Electronya/gt-wheel-main-board/README.md

# gt-wheel-main-board
GT DIY Wheel Main Board
