Electronya/gt-wheel-main-board/MainPCB.dxf

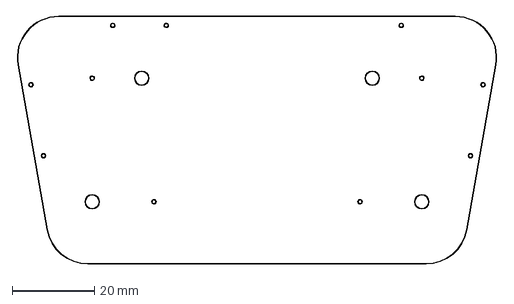
[picture p1: CAD file, 2023-06-29]
MainPCB.dxf
116.9 x 60.0 mm
