Electronya/gt-wheel-main-board/ENYA-SIMR-GTWL-PCMB.kicad_pcb

## KiCad design ENYA-SIMR-GTWL-PCMB.kicad_pcb (2023-11-08)

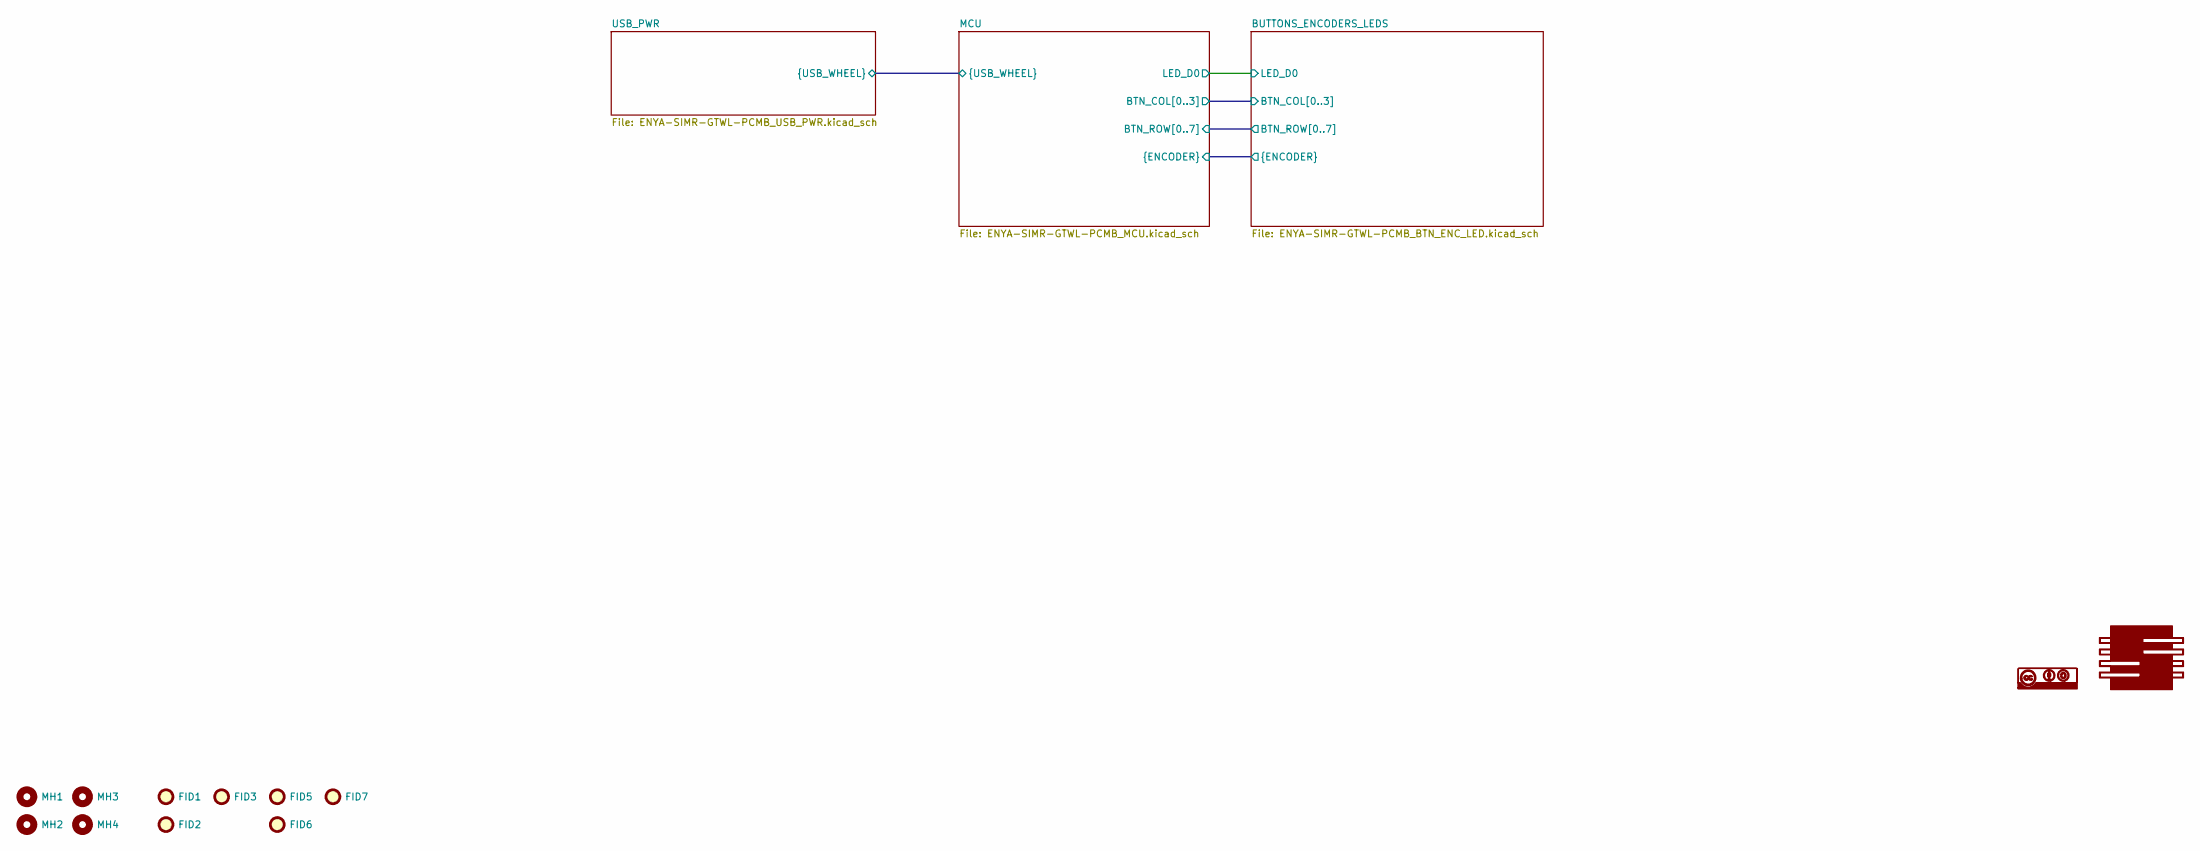
[picture p2: schematic ENYA-SIMR-GTWL-PCMB.kicad_sch, DIY GT Wheel Main Board]

Parts:
FID1, FID2, FID3, FID5, FID6, FID7: Fiducial; Fiducial_1.5mm_Mask3mm
G1: Electronya_Logo; Electronya_Logo_12MM
G2: CC-BY-SA_Logo; CC-BY-SA_10MM
MH1, MH2, MH3, MH4: MH-NPLTD-M3; MountingHole_3.2mm_M3_DIN965

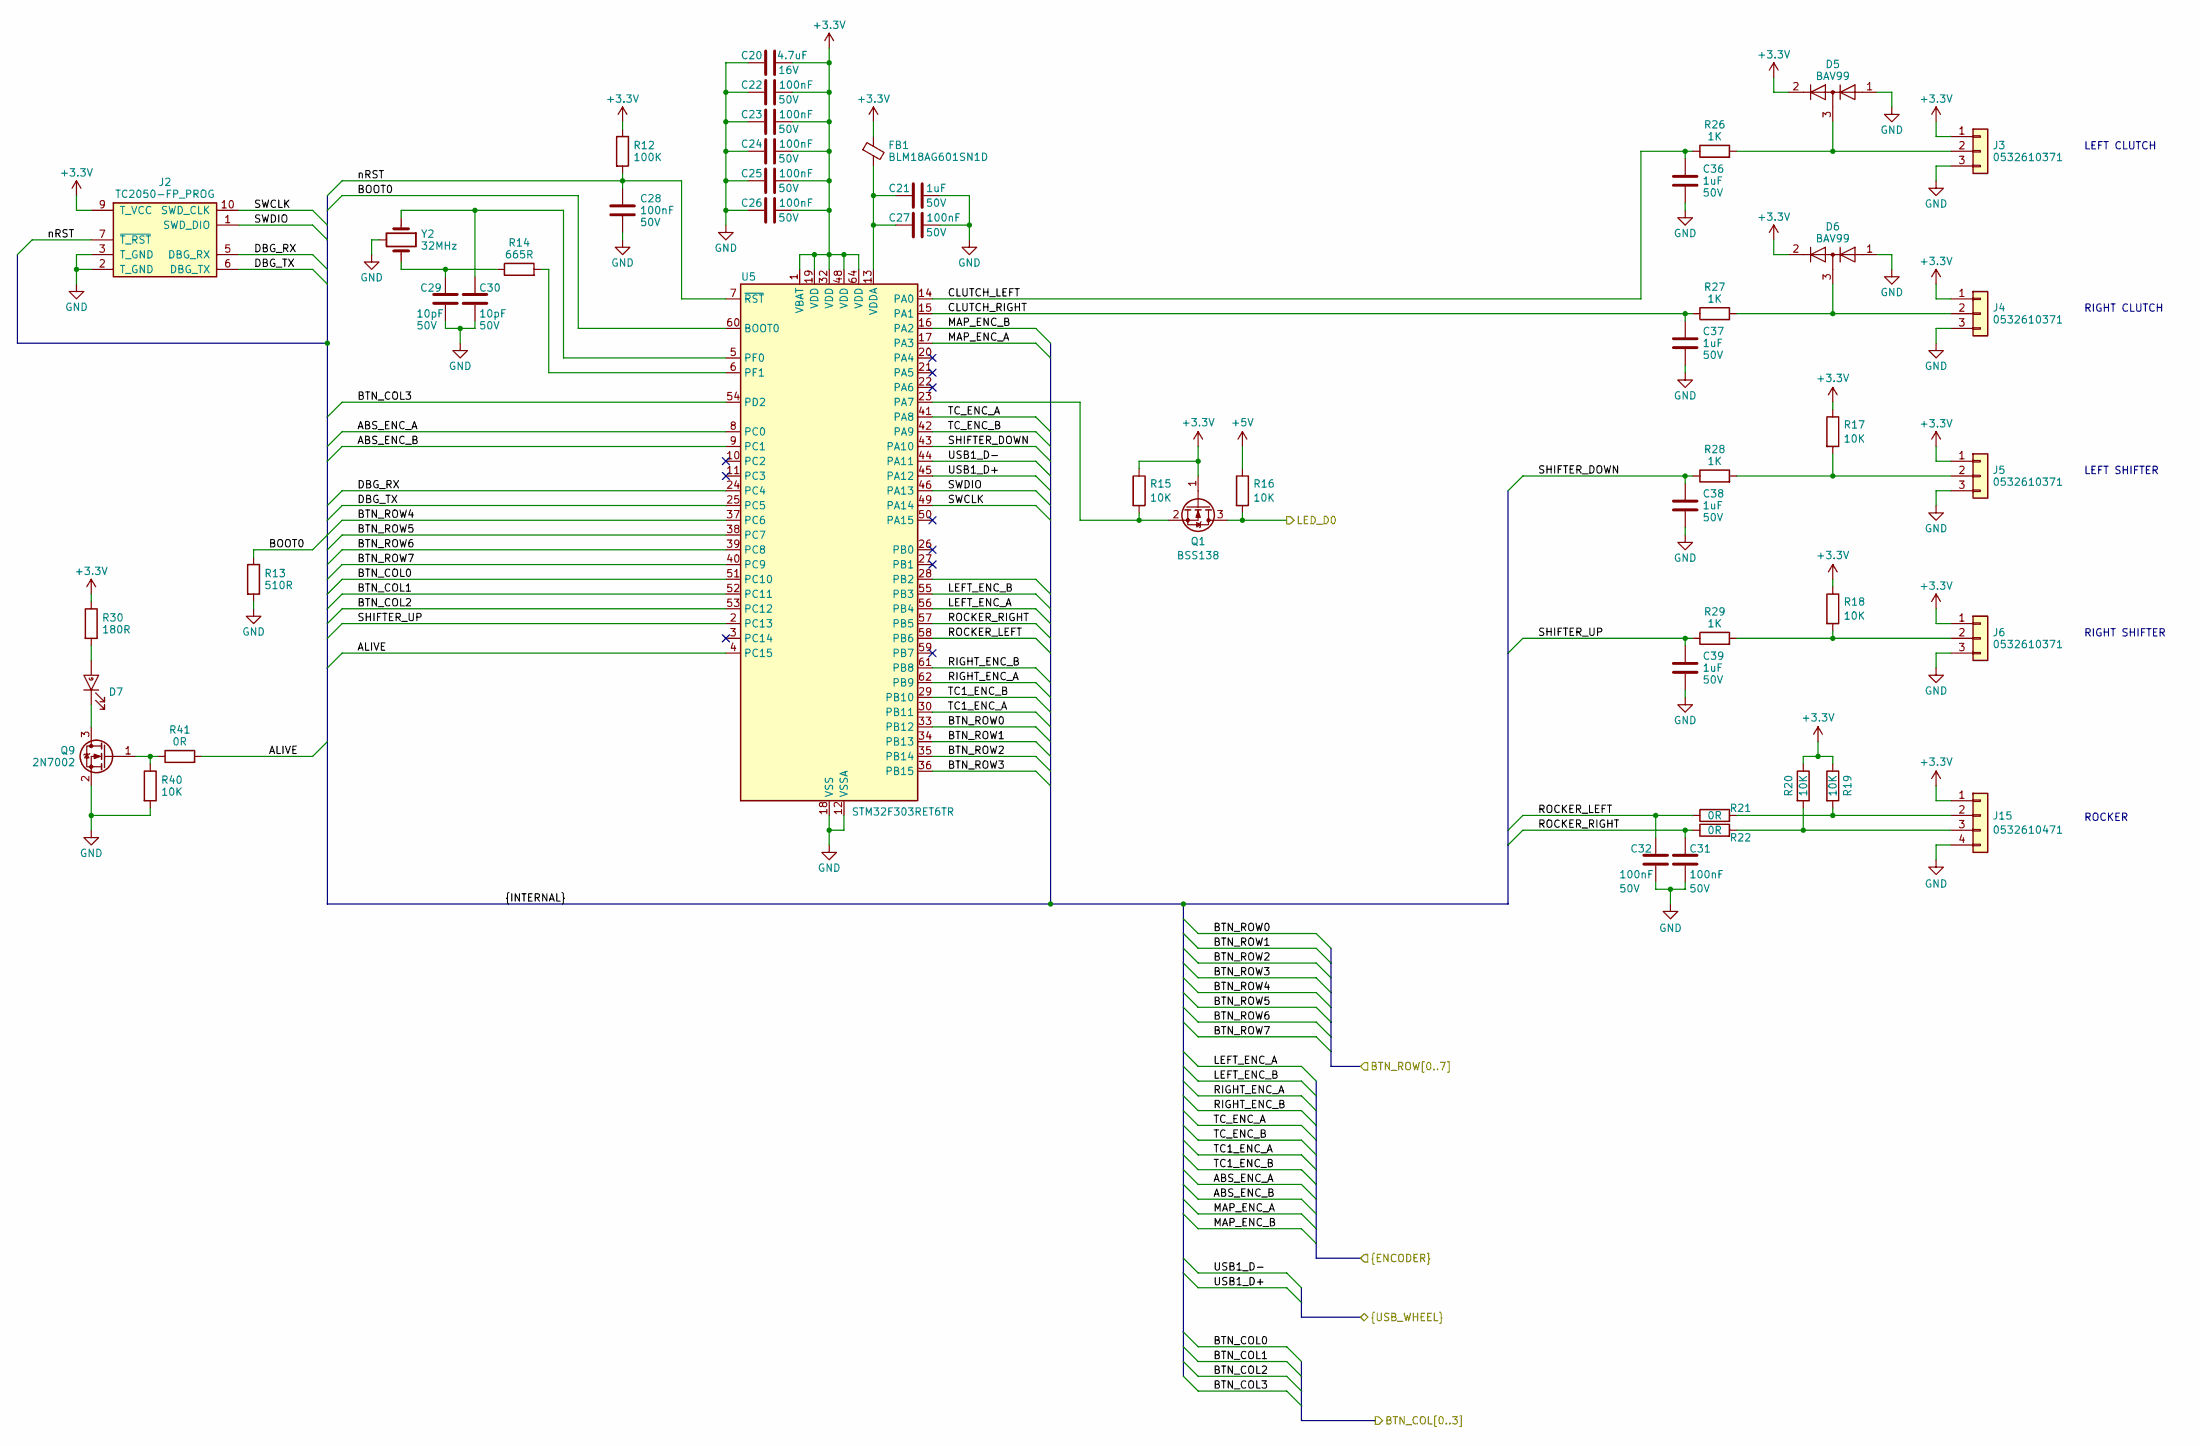
[picture p3: schematic ENYA-SIMR-GTWL-PCMB_MCU.kicad_sch, DIY GT Wheel Main Board]

Parts:
C20: 4.7uF_CER_0805_16V; C_0805_2012Metric; Voltage Rating 16V; Manufacturer Part Number CL21B475KOFNNNE; Digi-Key Part Number 1276-2873-1-ND
C21, C36, C37, C38, C39: 1uF_CER_0603_50V; C_0603_1608Metric; Voltage Rating 50V; Manufacturer Part Number UMK107BJ105KA-T; Digi-Key Part Number 587-2400-1-ND
C22, C23, C24, C25, C26, C27, C28, C31, C32: 100nF_CER_0603_50V; C_0603_1608Metric; Voltage Rating 50V; Manufacturer Part Number 06033D104MAT2A; Digi-Key Part Number 478-7905-1-ND
C29, C30: 10pF_CER_0603_50V; C_0603_1608Metric; Voltage Rating 50V; Manufacturer Part Number 06035A100JAT2A; Digi-Key Part Number 478-1163-1-ND
D5: BAV99; SOT-23
D6: BAV99_SOT-23; SOT-23; Manufacturer Part Number BAV99; Digi-Key Part Number 1655-BAV99CT-ND
D7: GRN_SMD_0603_0.3H; LED_0603_1608Metric; Manufacturer Part Number 150060GS73220; Digi-Key Part Number 732-11995-1-ND
FB1: 600R_100MHz_0R38_0603; L_0603_1608Metric; Manufacturer Part Number BLM18AG601SN1D; Digi-Key Part Number 490-1014-1-ND
J2: TC2050-FP_PROG; Tag-Connect_TC2050-IDC-FP_2x05_P1.27mm_Vertical; Manufacturer Part Number TC2050-FP
J3, J4, J5, J6: PICO_BLADE_1x3_MALE_RA_SMD; PICO_BLADE_53261_1x3_SMD_RA_1.25MM; Manufacturer Part Number 0532610371; Digi-Key Part Number WM7621CT-ND
J15: PICO_BLADE_1x4_MALE_RA_SMD; PICO_BLADE_53261_1x4_SMD_RA_1.25MM; Manufacturer Part Number 0532610471; Digi-Key Part Number WM7622CT-ND
Q1: BSS138; SOT-23; Manufacturer Part Number BSS138; Digi-Key Part Number BSS138CT-ND
Q9: 2N7002; SOT-23; Manufacturer Part Number 2N7002; Digi-Key Part Number 2N7002NCT-ND
R12: 100K_0603_100MW; R_0603_1608Metric; Manufacturer Part Number RC0603FR-07100KL; Digi-Key Part Number 311-100KHRCT-ND
R13: 510R_0603_100MW; R_0603_1608Metric; Manufacturer Part Number RC0603FR-07510RL; Digi-Key Part Number 311-510HRCT-ND
R14: 665R_0603_100MW; R_0603_1608Metric; Manufacturer Part Number RC0603FR-07665RL; Digi-Key Part Number 311-665HRCT-ND
R15, R16, R17, R18, R19, R20, R40: 10K_0603_100MW; R_0603_1608Metric; Manufacturer Part Number ERJ-3EKF1002V; Digi-Key Part Number P10.0KHCT-ND
R21, R22, R41: 0R_0603_100MW; R_0603_1608Metric; Manufacturer Part Number ERJ-3GEY0R00V; Digi-Key Part Number P0.0GCT-ND
R26, R27, R28, R29: 1K_0603_100MW; R_0603_1608Metric; Manufacturer Part Number ERJ-3EKF1001V; Digi-Key Part Number P1.00KHCT-ND
R30: 180R_0603_100MW; R_0603_1608Metric; Manufacturer Part Number RC0603FR-07180RL; Digi-Key Part Number 311-180HRCT-ND
U5: STM32F303RET6TR; LQFP-64_10x10mm_P0.5mm; Manufacturer Part Number STM32F303RET6TR; Digi-Key Part Number 497-18778-1-ND
Y2: ABM10_32MHz_10pF_SMD4_2.5x2.0; ABM10_SMD4_2.5x2.0mm; Manufacturer Part Number ABM10-32.000MHZ-D30-T3; Digi-Key Part Number 535-10936-1-ND

Connections:
+3.3V: C20.2, C22.2, C23.2, C24.2, C25.2, C26.2, D5.2 (A), D6.2 (A), FB1.1, J2.9 (T_VCC), J3.1, J4.1, J5.1, J6.1, J15.1, Q1.1 (G), R12.1, R15.1, R17.1, R18.1, R19.1, R20.1, R30.1, U5.1 (VBAT), U5.19 (VDD), U5.32 (VDD), U5.48 (VDD), U5.64 (VDD); also elsewhere on the board
+5V: R16.1; also elsewhere on the board
/BUTTONS_ENCODERS_LEDS/ABS_ENC_A: U5.8 (PC0); also elsewhere on the board
/BUTTONS_ENCODERS_LEDS/ABS_ENC_B: U5.9 (PC1); also elsewhere on the board
/BUTTONS_ENCODERS_LEDS/BTN_COL0: U5.51 (PC10); also elsewhere on the board
/BUTTONS_ENCODERS_LEDS/BTN_COL1: U5.52 (PC11); also elsewhere on the board
/BUTTONS_ENCODERS_LEDS/BTN_COL2: U5.53 (PC12); also elsewhere on the board
/BUTTONS_ENCODERS_LEDS/BTN_COL3: U5.54 (PD2); also elsewhere on the board
/BUTTONS_ENCODERS_LEDS/BTN_ROW0: U5.33 (PB12); also elsewhere on the board
/BUTTONS_ENCODERS_LEDS/BTN_ROW1: U5.34 (PB13); also elsewhere on the board
/BUTTONS_ENCODERS_LEDS/BTN_ROW2: U5.35 (PB14); also elsewhere on the board
/BUTTONS_ENCODERS_LEDS/BTN_ROW3: U5.36 (PB15); also elsewhere on the board
/BUTTONS_ENCODERS_LEDS/BTN_ROW4: U5.37 (PC6); also elsewhere on the board
/BUTTONS_ENCODERS_LEDS/BTN_ROW5: U5.38 (PC7); also elsewhere on the board
/BUTTONS_ENCODERS_LEDS/BTN_ROW6: U5.39 (PC8); also elsewhere on the board
/BUTTONS_ENCODERS_LEDS/BTN_ROW7: U5.40 (PC9); also elsewhere on the board
/BUTTONS_ENCODERS_LEDS/LED_D0: Q1.3 (D), R16.2; also elsewhere on the board
/BUTTONS_ENCODERS_LEDS/LEFT_ENC_A: U5.56 (PB4); also elsewhere on the board
/BUTTONS_ENCODERS_LEDS/LEFT_ENC_B: U5.55 (PB3); also elsewhere on the board
/BUTTONS_ENCODERS_LEDS/MAP_ENC_A: U5.17 (PA3); also elsewhere on the board
/BUTTONS_ENCODERS_LEDS/MAP_ENC_B: U5.16 (PA2); also elsewhere on the board
/BUTTONS_ENCODERS_LEDS/RIGHT_ENC_A: U5.62 (PB9); also elsewhere on the board
/BUTTONS_ENCODERS_LEDS/RIGHT_ENC_B: U5.61 (PB8); also elsewhere on the board
/BUTTONS_ENCODERS_LEDS/TC1_ENC_A: U5.30 (PB11); also elsewhere on the board
/BUTTONS_ENCODERS_LEDS/TC1_ENC_B: U5.29 (PB10); also elsewhere on the board
/BUTTONS_ENCODERS_LEDS/TC_ENC_A: U5.41 (PA8); also elsewhere on the board
/BUTTONS_ENCODERS_LEDS/TC_ENC_B: U5.42 (PA9); also elsewhere on the board
/MCU/ALIVE: R41.2, U5.4 (PC15)
/MCU/BOOT0: R13.1, U5.60 (BOOT0)
/MCU/CLUTCH_LEFT: C36.1, R26.1, U5.14 (PA0)
/MCU/CLUTCH_RIGHT: C37.1, R27.1, U5.15 (PA1)
/MCU/DBG_RX: J2.5 (DBG_RX), U5.24 (PC4)
/MCU/DBG_TX: J2.6 (DBG_TX), U5.25 (PC5)
/MCU/ROCKER_LEFT: C32.1, R21.1, U5.58 (PB6)
/MCU/ROCKER_RIGHT: C31.1, R22.1, U5.57 (PB5)
/MCU/SHIFTER_DOWN: C38.1, R28.1, U5.43 (PA10)
/MCU/SHIFTER_UP: C39.1, R29.1, U5.2 (PC13)
/MCU/SWCLK: J2.10 (SWD_CLK), U5.49 (PA14)
/MCU/SWDIO: J2.1 (SWD_DIO), U5.46 (PA13)
/MCU/USB1_D+: U5.45 (PA12); also elsewhere on the board
/MCU/USB1_D-: U5.44 (PA11); also elsewhere on the board
/MCU/nRST: C28.1, J2.7 (~T_RST), R12.2, U5.7 (~RST)
GND: C20.1, C21.2, C22.1, C23.1, C24.1, C25.1, C26.1, C27.2, C28.2, C29.2, C30.2, C31.2, C32.2, C36.2, C37.2, C38.2, C39.2, D5.1 (K), D6.1 (K), J2.2 (T_GND), J2.3 (T_GND), J3.3, J4.3, J5.3, J6.3, J15.4, Q9.2 (S), R13.2, R40.2, U5.12 (VSSA), U5.18 (VSS), U5.31 (VSS), U5.47 (VSS), U5.63 (VSS), Y2.2 (GND), Y2.4 (GND); also elsewhere on the board
unnamed: C29.1, R14.1, Y2.3
unnamed: D7.2 (A), R30.2
unnamed: D7.1 (K), Q9.3 (D)
unnamed: D5.3 (K), J3.2, R26.2
unnamed: D6.3 (K), J4.2, R27.2
unnamed: J5.2, R17.2, R28.2
unnamed: J6.2, R18.2, R29.2
unnamed: J15.2, R19.2, R21.2
unnamed: J15.3, R20.2, R22.2
unnamed: Q1.2 (S), R15.2, U5.23 (PA7)
unnamed: Q9.1 (G), R40.1, R41.1
unnamed: C30.1, U5.5 (PF0), Y2.1
unnamed: R14.2, U5.6 (PF1)
unnamed: C21.1, C27.1, FB1.2, U5.13 (VDDA)

Notes on the sheet:
RIGHT CLUTCH
RIGHT SHIFTER
ROCKER
LEFT SHIFTER
LEFT CLUTCH

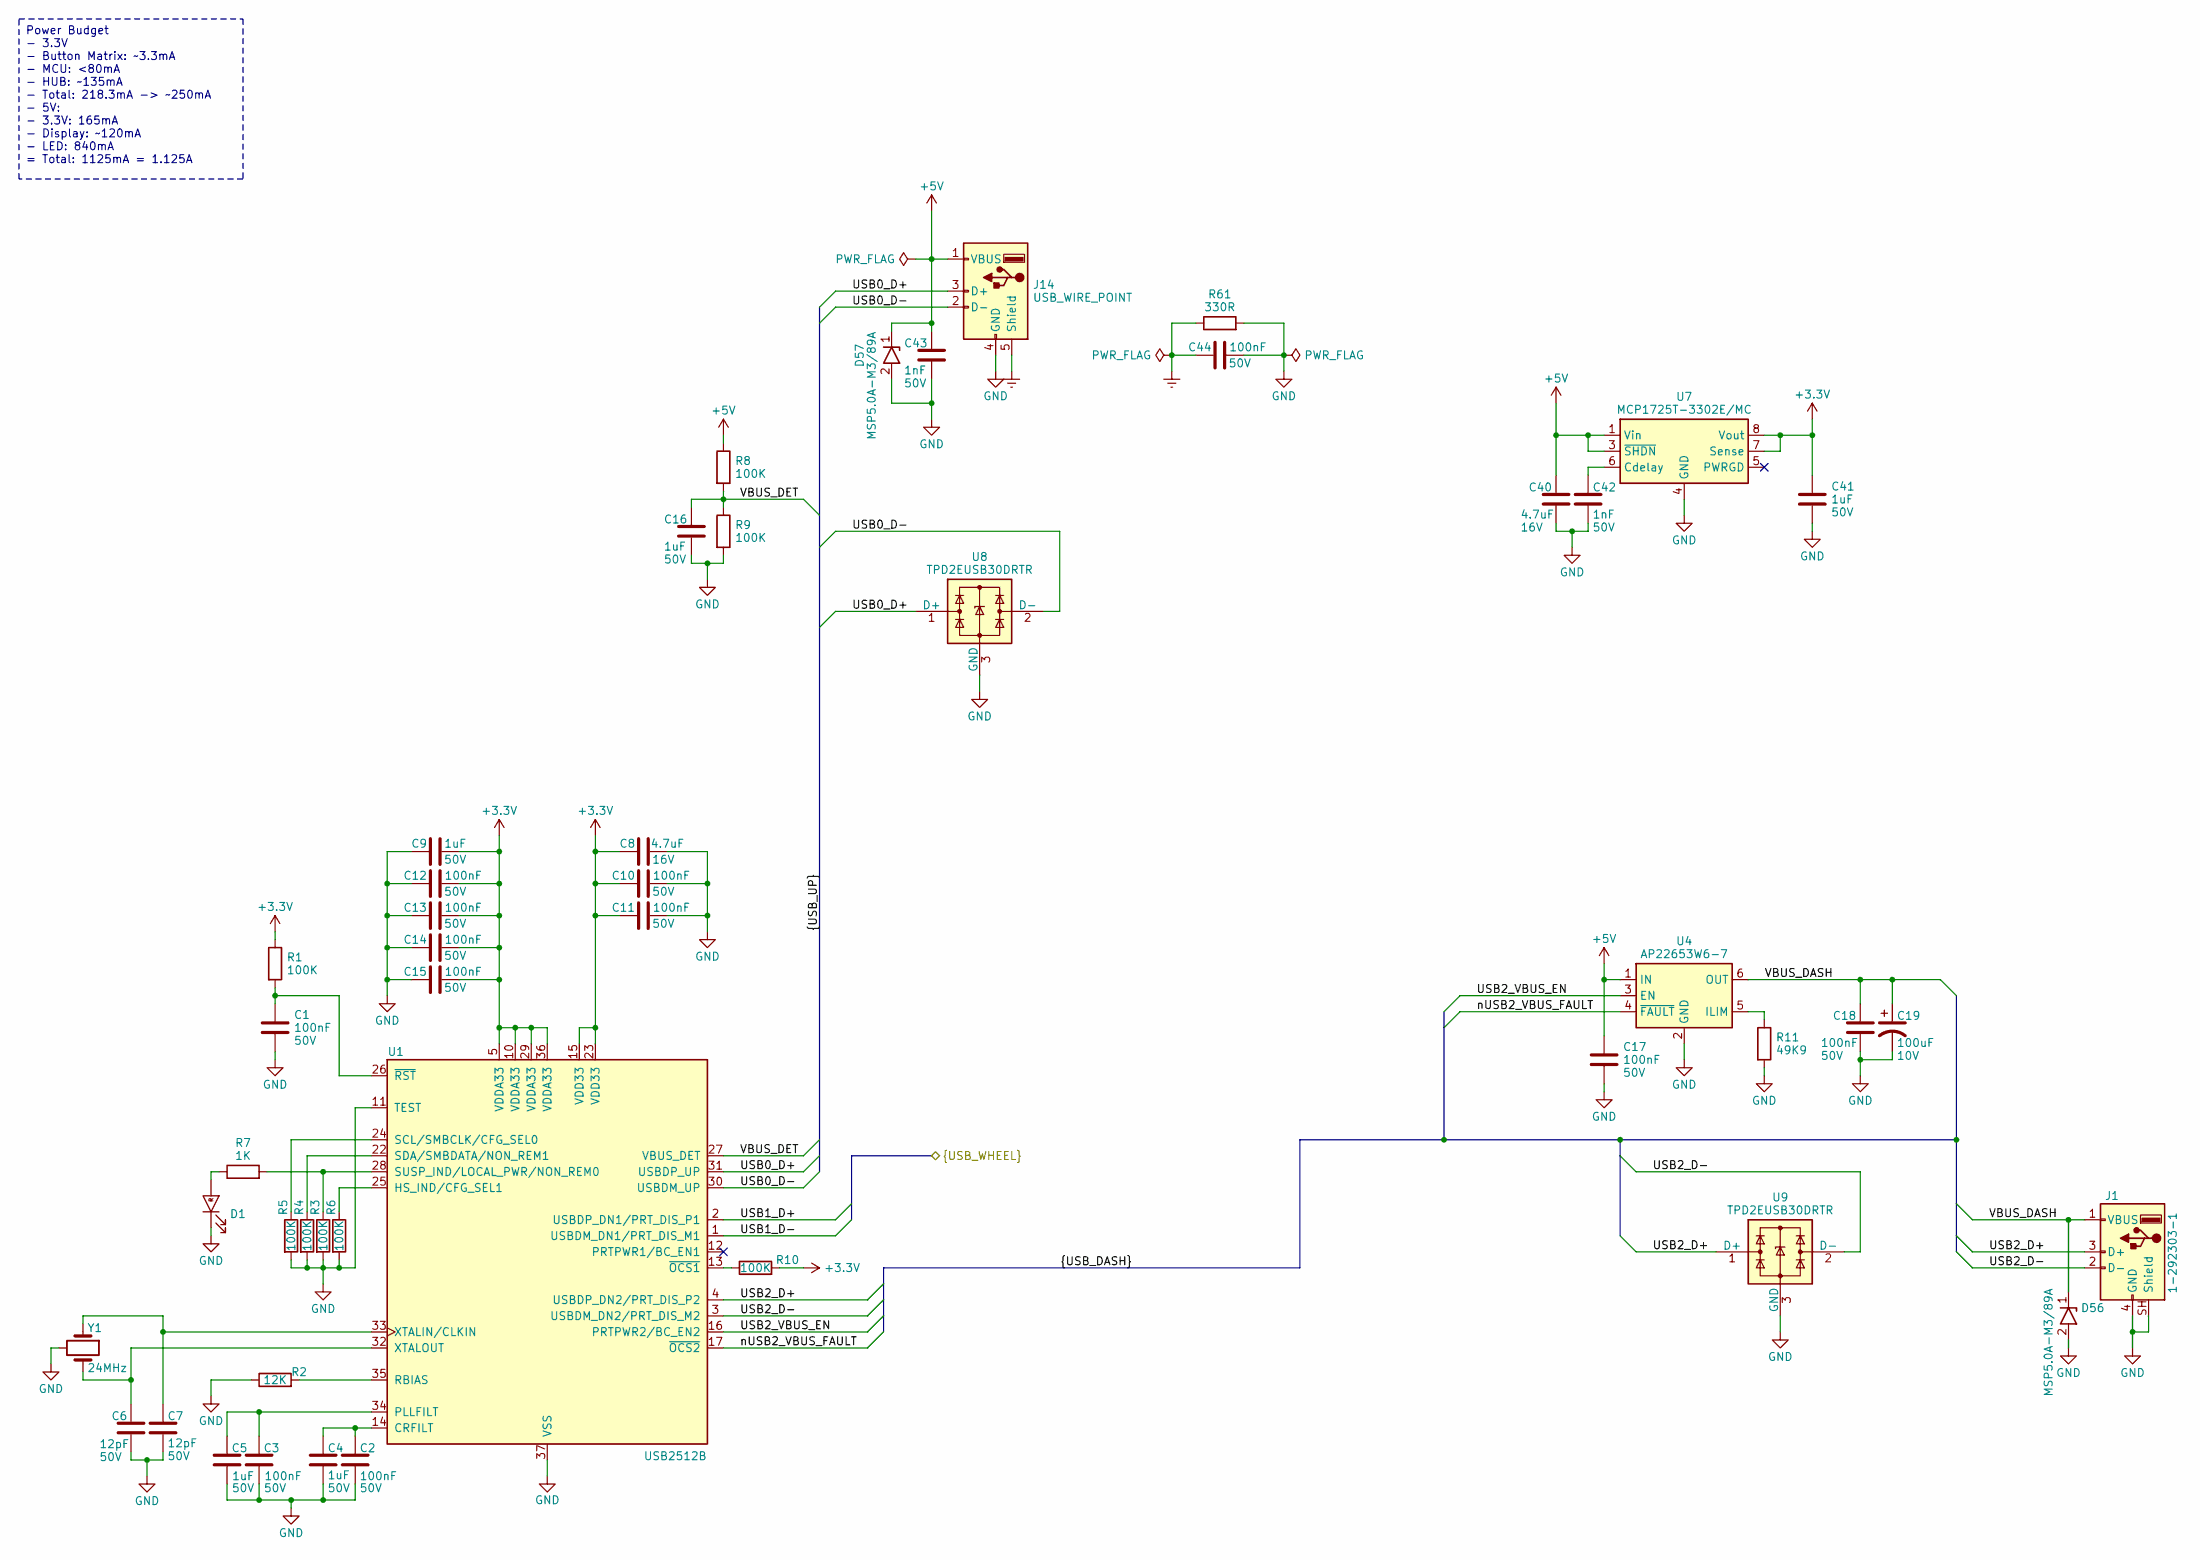
[picture p4: schematic ENYA-SIMR-GTWL-PCMB_USB_PWR.kicad_sch, DIY GT Wheel Main Board]

Parts:
C1, C2, C3, C10, C11, C12, C13, C14, C15, C17, C18, C44: 100nF_CER_0603_50V; C_0603_1608Metric; Voltage Rating 50V; Manufacturer Part Number 06033D104MAT2A; Digi-Key Part Number 478-7905-1-ND
C4, C5, C9, C16, C41: 1uF_CER_0603_50V; C_0603_1608Metric; Voltage Rating 50V; Manufacturer Part Number UMK107BJ105KA-T; Digi-Key Part Number 587-2400-1-ND
C6, C7: 12pF_CER_0603_50V; C_0603_1608Metric; Voltage Rating 50V; Manufacturer Part Number CGA3E2C0G1H120J080AA; Digi-Key Part Number 445-5629-1-ND
C8, C40: 4.7uF_CER_0805_16V; C_0805_2012Metric; Voltage Rating 16V; Manufacturer Part Number CL21B475KOFNNNE; Digi-Key Part Number 1276-2873-1-ND
C19: 100UF_TANT_2917_10V; CP_EIA-7343-15_Kemet-W; Voltage Rating 10V; Manufacturer Part Number TAJD107M010RNJ; Digi-Key Part Number 478-3918-1-ND
C42, C43: 1nF_CER_0603_50V; C_0603_1608Metric; Voltage Rating 50V; Manufacturer Part Number C0603C102K5RAC7867; Digi-Key Part Number 399-C0603C102K5RAC7867CT-ND
D1: RED_SMD_0603_0.3H; LED_0603_1608Metric; Manufacturer Part Number 150060RS75000; Digi-Key Part Number 732-4978-1-ND
D56, D57: MSP5.0A_5V_9.2V_D0-219AD; DO-219AD; Manufacturer Part Number MSP5.0A-M3/89A; Digi-Key Part Number MSP5.0A-M3/89AGICT-ND
J1: USB_A_RA; Manufacturer Part Number 1-292303-1; Digi-Key Part Number A127890-ND
J14: USB_WIRE_POINT
R1, R3, R4, R5, R6, R8, R9, R10: 100K_0603_100MW; R_0603_1608Metric; Manufacturer Part Number RC0603FR-07100KL; Digi-Key Part Number 311-100KHRCT-ND
R2: 12K_0603_100MW; R_0603_1608Metric; Manufacturer Part Number RC0603FR-0712KL; Digi-Key Part Number 311-12.0KHRCT-ND
R7: 1K_0603_100MW; R_0603_1608Metric; Manufacturer Part Number ERJ-3EKF1001V; Digi-Key Part Number P1.00KHCT-ND
R11: 49K9_0603_100MW; R_0603_1608Metric; Manufacturer Part Number CRCW060349K9FKEAC; Digi-Key Part Number 541-3989-1-ND
R61: 330R_0603_100MW; R_0603_1608Metric; Manufacturer Part Number RC0603FR-07330RL; Digi-Key Part Number 311-330HRCT-ND
U1: USB2512B; QFN-36-1EP_6x6mm_P0.5mm_EP3.7x3.7mm; Manufacturer Part Number USB2512B-AEZG-TR; Digi-Key Part Number USB2512B-AEZG-CT-ND
U4: AP22653W6-7_ILIM_2.1A_SOT-23-6; SOT-23-6; Manufacturer Part Number AP22653W6-7; Digi-Key Part Number 31-AP22653W6-7CT-ND
U7: MCP1725_3.3V_500mA_DFN-8; DFN-8-1EP_3x2mm_P0.5mm_EP1.75x1.45mm; Manufacturer Part Number MCP1725T-3302E/MC; Digi-Key Part Number MCP1725T-3302E/MCCT-ND
U8, U9: TPD2EUSB30_5.5V_8V_SOT-3; Texas_DRT-3; Manufacturer PArt Number TPD2EUSB30DRTR; Digi-Key Part Number 296-25509-1-ND
Y1: ABM10_24MHz_10pF_SMD4_2.5x2.0; ABM10_SMD4_2.5x2.0mm; Manufacturer Part Number ABM10-24.000MHZ-E20-T; Digi-Key Part Number 535-9093-1-ND

Connections:
+3.3V: C8.1, C9.2, C10.1, C11.1, C12.2, C13.2, C14.2, C15.2, C41.1, R1.1, R10.2, U1.5 (VDDA33), U1.10 (VDDA33), U1.15 (VDD33), U1.23 (VDD33), U1.29 (VDDA33), U1.36 (VDDA33), U7.7 (Sense), U7.8 (Vout); also elsewhere on the board
+5V: C17.1, C40.1, C43.1, D57.1 (A1), J14.1 (VBUS), R8.1, U4.1 (IN), U7.1 (Vin), U7.2 (Vin), U7.3 (~SHDN); also elsewhere on the board
/MCU/USB1_D+: U1.2 (USBDP_DN1/PRT_DIS_P1); also elsewhere on the board
/MCU/USB1_D-: U1.1 (USBDM_DN1/PRT_DIS_M1); also elsewhere on the board
/USB_PWR/USB0_D+: J14.3 (D+), U1.31 (USBDP_UP), U8.1 (D+)
/USB_PWR/USB0_D-: J14.2 (D-), U1.30 (USBDM_UP), U8.2 (D-)
/USB_PWR/USB2_D+: J1.3 (D+), U1.4 (USBDP_DN2/PRT_DIS_P2), U9.1 (D+)
/USB_PWR/USB2_D-: J1.2 (D-), U1.3 (USBDM_DN2/PRT_DIS_M2), U9.2 (D-)
/USB_PWR/USB2_VBUS_EN: U1.16 (PRTPWR2/BC_EN2), U4.3 (EN)
/USB_PWR/VBUS_DASH: C18.1, C19.1, D56.1 (A1), J1.1 (VBUS), U4.6 (OUT)
/USB_PWR/VBUS_DET: C16.1, R8.2, R9.1, U1.27 (VBUS_DET)
/USB_PWR/nUSB2_VBUS_FAULT: U1.17 (~OCS2), U4.4 (~FAULT)
Earth: C44.1, J14.5 (Shield), R61.1
GND: C1.2, C2.2, C3.2, C4.2, C5.2, C6.2, C7.2, C8.2, C9.1, C10.2, C11.2, C12.1, C13.1, C14.1, C15.1, C16.2, C17.2, C18.2, C19.2, C40.2, C41.2, C42.2, C43.2, C44.2, D1.1 (K), D56.2 (A2), D57.2 (A2), J1.4 (GND), J1.SH (Shield), J14.4 (GND), R2.1, R3.2, R4.2, R5.2, R6.2, R9.2, R11.2, R61.2, U1.11 (TEST), U1.37 (VSS), U4.2 (GND), U7.4 (GND), U7.9 (GND), U8.3 (GND), U9.3 (GND), Y1.2 (GND), Y1.4 (GND); also elsewhere on the board
unnamed: D1.2 (A), R7.1
unnamed: C2.1, C4.1, U1.14 (CRFILT)
unnamed: R6.1, U1.25 (HS_IND/CFG_SEL1)
unnamed: C3.1, C5.1, U1.34 (PLLFILT)
unnamed: R2.2, U1.35 (RBIAS)
unnamed: R5.1, U1.24 (SCL/SMBCLK/CFG_SEL0)
unnamed: R4.1, U1.22 (SDA/SMBDATA/NON_REM1)
unnamed: R3.1, R7.2, U1.28 (SUSP_IND/LOCAL_PWR/NON_REM0)
unnamed: C7.1, U1.33 (XTALIN/CLKIN), Y1.1
unnamed: C6.1, U1.32 (XTALOUT), Y1.3
unnamed: R10.1, U1.13 (~OCS1)
unnamed: C1.1, R1.2, U1.26 (~RST)
unnamed: R11.1, U4.5 (ILIM)
unnamed: C42.1, U7.6 (Cdelay)

Notes on the sheet:
Power Budget - 3.3V - Button Matrix: ~3.3mA - MCU: <80mA - HUB: ~135mA - Total: 218.3mA -> ~250mA - 5V: - 3.3V: 165mA - Display: ~120mA - LED: 840mA = Total: 1125mA = 1.125A

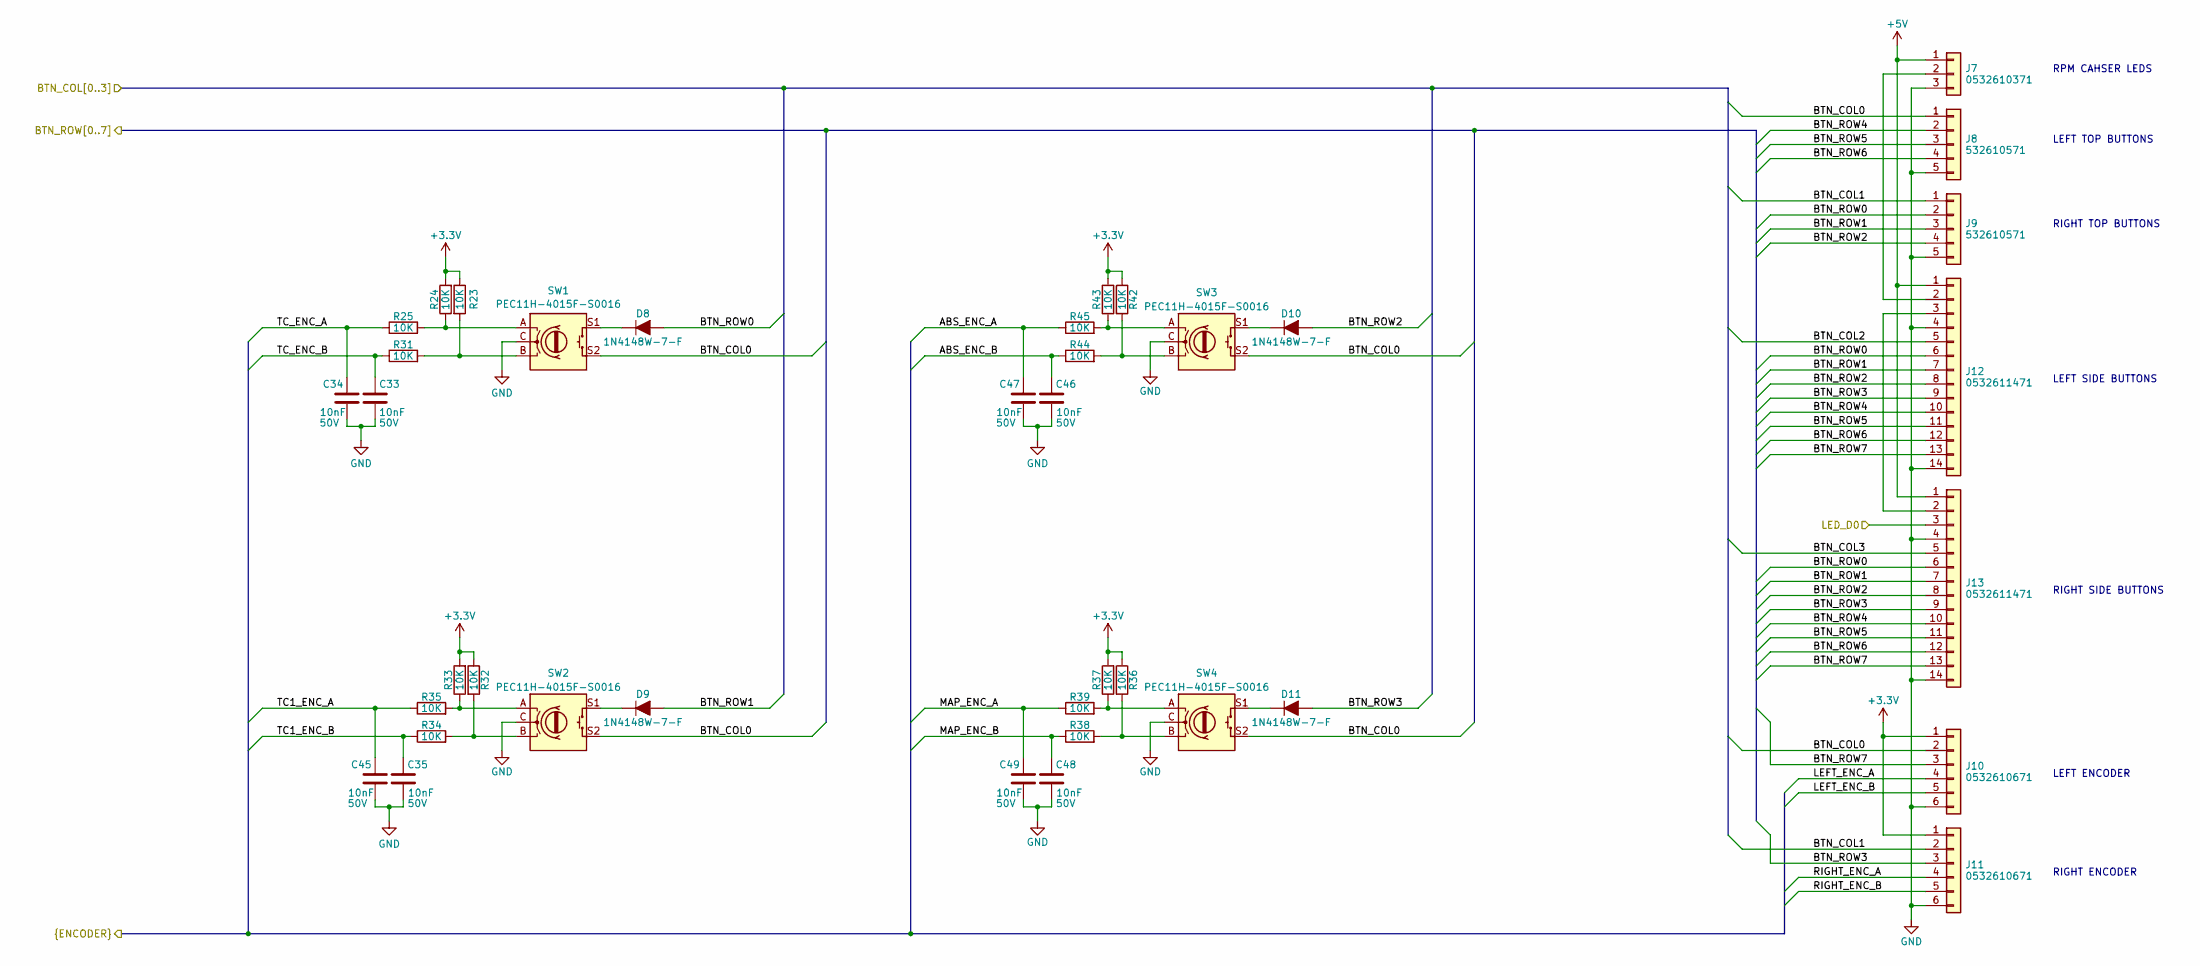
[picture p5: schematic ENYA-SIMR-GTWL-PCMB_BTN_ENC_LED.kicad_sch, DIY GT Wheel Main Board]

Parts:
C33, C34, C35, C45, C46, C47, C48, C49: 10nF_CER_0603_50V; C_0603_1608Metric; Voltage Rating 50V; Manufacturer Part Number 06035C103KAT2A; Digi-Key Part Number 478-1227-1-ND
D8, D9, D10, D11: 1N4148W-7-F; D_SOD-123; Manufacturer Part Number 1N4148W-7-F; Digi-Key Part Number 1N4148W-FDICT-ND
J7: PICO_BLADE_1x3_MALE_RA_SMD; PICO_BLADE_53261_1x3_SMD_RA_1.25MM; Manufacturer Part Number 0532610371; Digi-Key Part Number WM7621CT-ND
J8, J9: PICO_BLADE_1x5_MALE_RA_SMD; PICO_BLADE_53261_1x5_SMD_RA_1.25MM; Manufacturer Part Number 532610571; Digi-Key Part Number WM7623CT-ND
J10, J11: PICO_BLADE_1x6_MALE_RA_SMD; PICO_BLADE_53261_1x6_SMD_RA_1.25MM; Manufacturer Part Number 0532610671; Digi-Key Part Number WM7624CT-ND
J12, J13: PICO_BLADE_1x14_MALE_RA_SMD; PICO_BLADE_53261_1x14_SMD_RA_1.25MM; Manufacturer Part Number 0532611471; Digi-Key Part Number WM7631CT-ND
R23, R24, R25, R31, R32, R33, R34, R35, R36, R37, R38, R39, R42, R43, R44, R45: 10K_0603_100MW; R_0603_1608Metric; Manufacturer Part Number ERJ-3EKF1002V; Digi-Key Part Number P10.0KHCT-ND
SW1, SW2, SW3, SW4: PEC11H-4015F-S0016; PEC11H_Switch_Vertical; Manufacturer Part Number PEC11H-4015F-S0016; Digi-Key Part Number 118-PEC11H-4015F-S0016-ND

Connections:
+3.3V: J10.1, J11.1, R23.1, R24.2, R32.1, R33.2, R36.1, R37.2, R42.1, R43.2; also elsewhere on the board
+5V: J7.1, J12.1, J13.1; also elsewhere on the board
/BUTTONS_ENCODERS_LEDS/ABS_ENC_A: C47.1, R45.1; also elsewhere on the board
/BUTTONS_ENCODERS_LEDS/ABS_ENC_B: C46.1, R44.1; also elsewhere on the board
/BUTTONS_ENCODERS_LEDS/BTN_COL0: J8.1, J10.2, SW1.S2, SW2.S2, SW3.S2, SW4.S2; also elsewhere on the board
/BUTTONS_ENCODERS_LEDS/BTN_COL1: J9.1, J11.2; also elsewhere on the board
/BUTTONS_ENCODERS_LEDS/BTN_COL2: J12.5; also elsewhere on the board
/BUTTONS_ENCODERS_LEDS/BTN_COL3: J13.5; also elsewhere on the board
/BUTTONS_ENCODERS_LEDS/BTN_ROW0: D8.2 (A), J9.2, J12.6, J13.6; also elsewhere on the board
/BUTTONS_ENCODERS_LEDS/BTN_ROW1: D9.2 (A), J9.3, J12.7, J13.7; also elsewhere on the board
/BUTTONS_ENCODERS_LEDS/BTN_ROW2: D10.2 (A), J9.4, J12.8, J13.8; also elsewhere on the board
/BUTTONS_ENCODERS_LEDS/BTN_ROW3: D11.2 (A), J11.3, J12.9, J13.9; also elsewhere on the board
/BUTTONS_ENCODERS_LEDS/BTN_ROW4: J8.2, J12.10, J13.10; also elsewhere on the board
/BUTTONS_ENCODERS_LEDS/BTN_ROW5: J8.3, J12.11, J13.11; also elsewhere on the board
/BUTTONS_ENCODERS_LEDS/BTN_ROW6: J8.4, J12.12, J13.12; also elsewhere on the board
/BUTTONS_ENCODERS_LEDS/BTN_ROW7: J10.3, J12.13, J13.13; also elsewhere on the board
/BUTTONS_ENCODERS_LEDS/LED_D0: J13.3; also elsewhere on the board
/BUTTONS_ENCODERS_LEDS/LEFT_ENC_A: J10.4; also elsewhere on the board
/BUTTONS_ENCODERS_LEDS/LEFT_ENC_B: J10.5; also elsewhere on the board
/BUTTONS_ENCODERS_LEDS/MAP_ENC_A: C49.1, R39.1; also elsewhere on the board
/BUTTONS_ENCODERS_LEDS/MAP_ENC_B: C48.1, R38.1; also elsewhere on the board
/BUTTONS_ENCODERS_LEDS/RIGHT_ENC_A: J11.4; also elsewhere on the board
/BUTTONS_ENCODERS_LEDS/RIGHT_ENC_B: J11.5; also elsewhere on the board
/BUTTONS_ENCODERS_LEDS/TC1_ENC_A: C45.1, R35.1; also elsewhere on the board
/BUTTONS_ENCODERS_LEDS/TC1_ENC_B: C35.1, R34.1; also elsewhere on the board
/BUTTONS_ENCODERS_LEDS/TC_ENC_A: C34.1, R25.1; also elsewhere on the board
/BUTTONS_ENCODERS_LEDS/TC_ENC_B: C33.1, R31.1; also elsewhere on the board
GND: C33.2, C34.2, C35.2, C45.2, C46.2, C47.2, C48.2, C49.2, J7.3, J8.5, J9.5, J10.6, J11.6, J12.4, J12.14, J13.4, J13.14, SW1.C, SW2.C, SW3.C, SW4.C; also elsewhere on the board
unnamed: D8.1 (K), SW1.S1
unnamed: D9.1 (K), SW2.S1
unnamed: D10.1 (K), SW3.S1
unnamed: D11.1 (K), SW4.S1
unnamed: J7.2, J12.2
unnamed: J12.3, J13.2
unnamed: R23.2, R31.2, SW1.B
unnamed: R24.1, R25.2, SW1.A
unnamed: R32.2, R34.2, SW2.B
unnamed: R33.1, R35.2, SW2.A
unnamed: R36.2, R38.2, SW4.B
unnamed: R37.1, R39.2, SW4.A
unnamed: R42.2, R44.2, SW3.B
unnamed: R43.1, R45.2, SW3.A

Notes on the sheet:
LEFT ENCODER
RIGHT SIDE BUTTONS
LEFT SIDE BUTTONS
RIGHT TOP BUTTONS
LEFT TOP BUTTONS
RIGHT ENCODER
RPM CAHSER LEDS

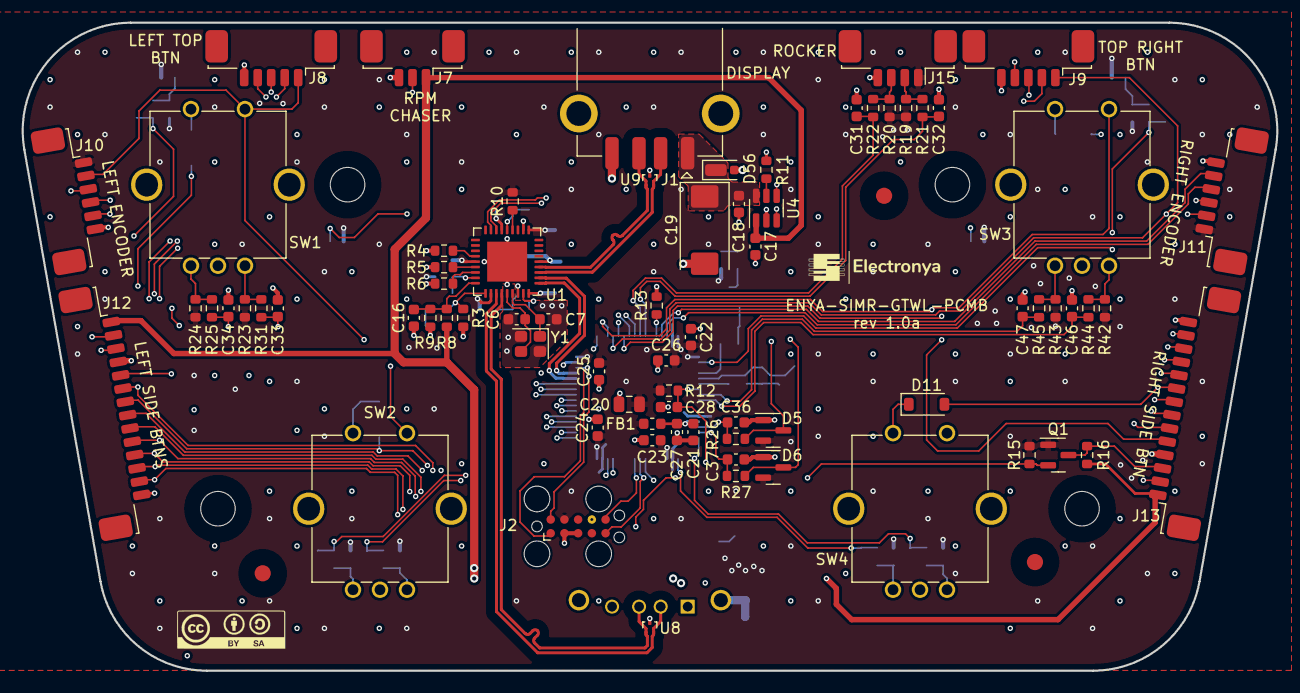
[picture p6: board ENYA-SIMR-GTWL-PCMB.kicad_pcb from above]

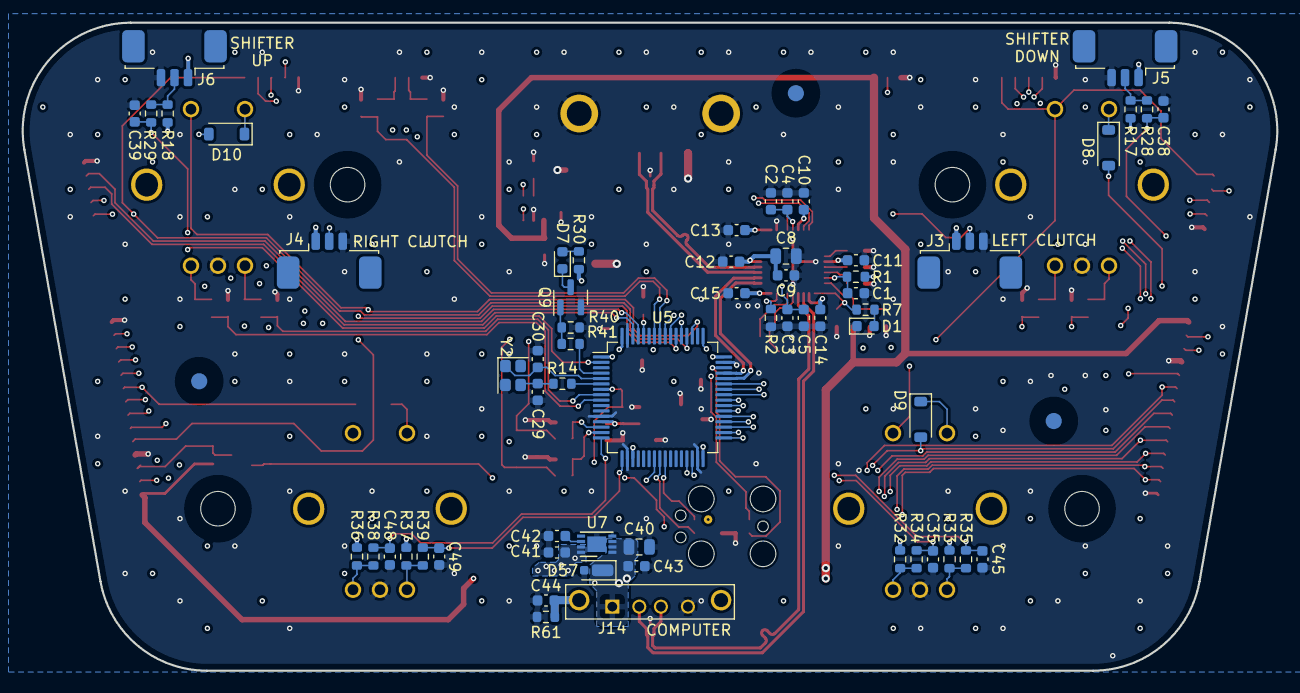
[picture p7: board ENYA-SIMR-GTWL-PCMB.kicad_pcb from below]

Board: 4 copper layers, 116.2 x 60.0 mm, 147 parts (64 on the bottom side), 94 nets.
