Electronya/gt-wheel-main-board/(commit log)

2023-06-23 project creation
    [ENYA-SIMR-GTWL-PCMB.kicad_pcb, ENYA-SIMR-GTWL-PCMB.kicad_sch, MainPCB.dxf]
2023-06-29 schematic + PCB done. ready to tag and order
    [ENYA-SIMR-GTWL-PCMB.kicad_sch, ENYA-SIMR-GTWL-PCMB_BTN_ENC_LED.kicad_sch, ENYA-SIMR-GTWL-PCMB_MCU.kicad_sch, ENYA-SIMR-GTWL-PCMB_USB_PWR.kicad_sch, MainPCB.dxf]
2023-07-01 using only one diode per selector switch + adding ferrite on VDDA
    [ENYA-SIMR-GTWL-PCMB_BTN_ENC_LED.kicad_sch, ENYA-SIMR-GTWL-PCMB_MCU.kicad_sch]
2023-10-08 rework for encoder instead of selector switch
    [ENYA-SIMR-GTWL-PCMB.kicad_pcb, ENYA-SIMR-GTWL-PCMB.kicad_sch, ENYA-SIMR-GTWL-PCMB_BTN_ENC_LED.kicad_sch, ENYA-SIMR-GTWL-PCMB_MCU.kicad_sch, ENYA-SIMR-GTWL-PCMB_USB_PWR.kicad_sch]
