Electronya/gt-wheel-main-board/(notices)

Notices in the files:
parts and their libraries:
CC-BY-SA, creative common
